eceelango/BIT--VSD-FPGA-Mini-Maze/PCB/schematic.pdf

1k 2 1

## Voltage Regulator for 5V

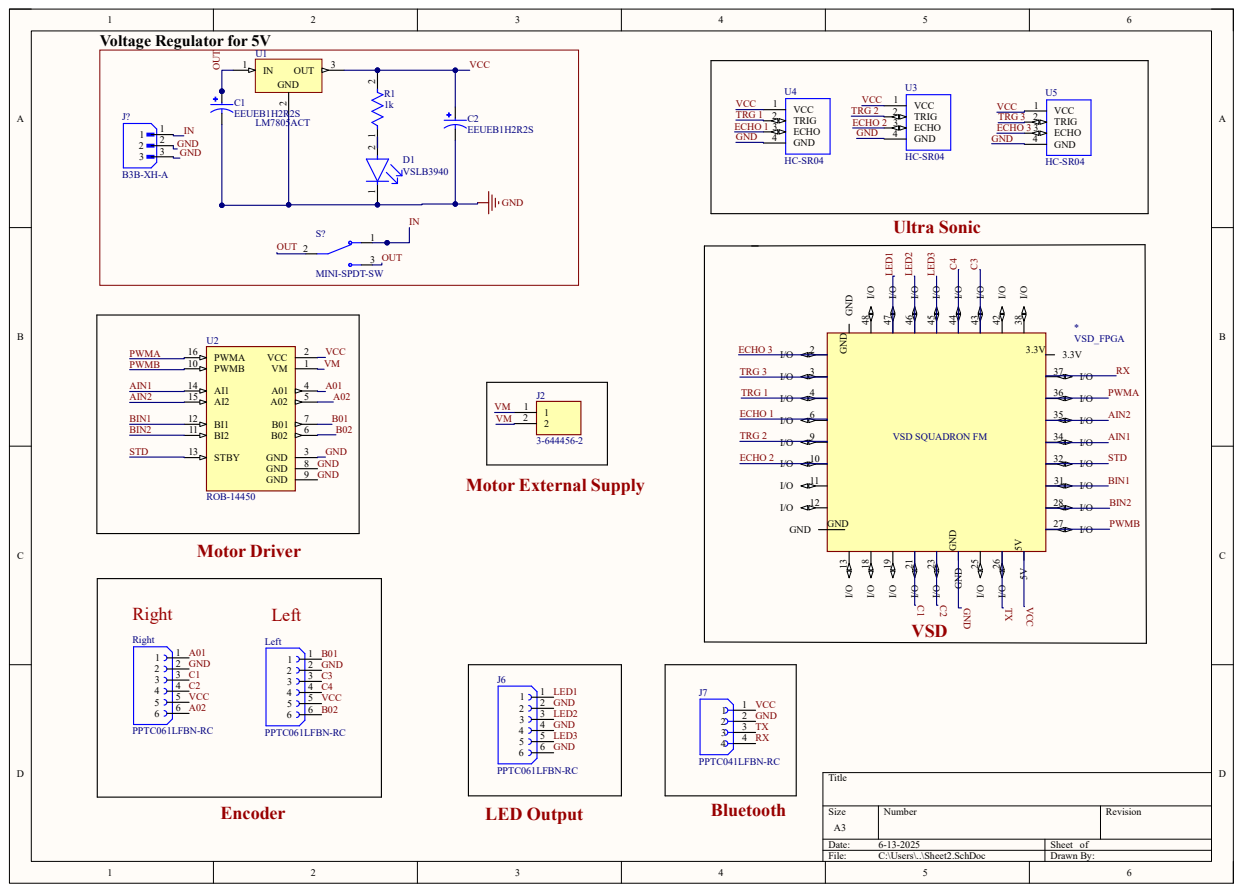
[picture p15: page 1]
