eceelango/BIT--VSD-FPGA-Mini-Maze/(commit log)

2025-08-02 uploaded PCB files
2025-08-02 Create pcb
